climbalima/split-pcb-throughole/splanck throughhole.kicad_pcb

## KiCad design splanck throughhole.kicad_pcb (2016-11-23)

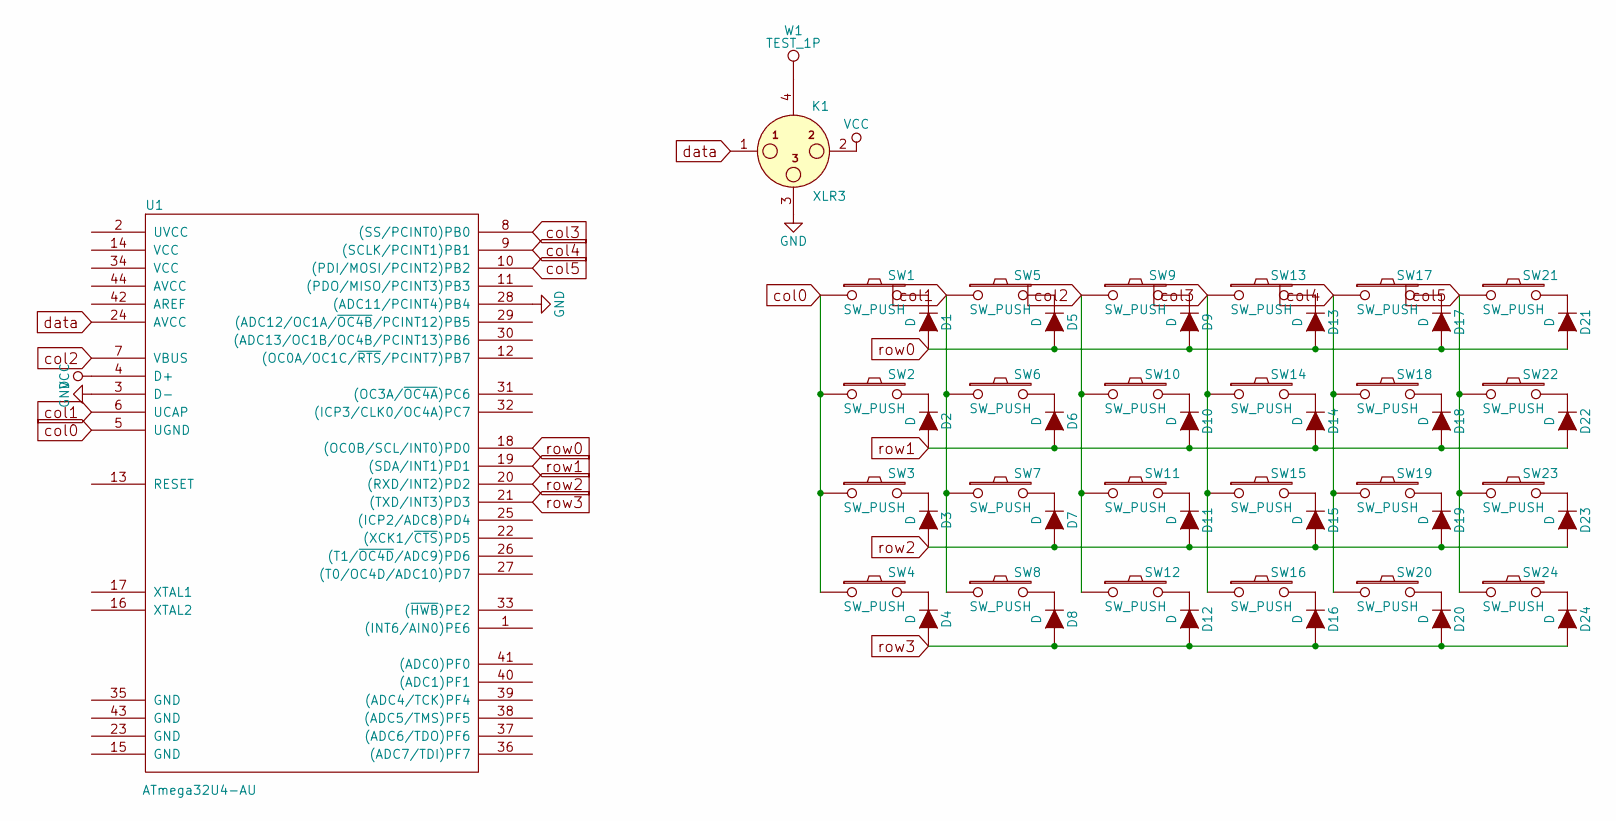
[picture p1: schematic splanck throughhole.sch]

Parts:
D1, D2, D3, D4, D5, D6, D7, D8, D9, D10, D11, D12, D13, D14, D15, D16, D17, D18, D19, D20, D21, D22, D23, D24: D; DIODE
K1: XLR3; 4pin35mmAudio
SW1, SW2, SW3, SW4, SW5, SW6, SW7, SW8, SW9, SW10, SW11, SW12, SW13, SW14, SW15, SW16, SW17, SW18, SW19, SW20, SW21, SW22, SW23, SW24: SW_PUSH; CHERRY_PCB_100H
U1: ATmega32U4-AU; TEENSY_2.0
W1: TEST_1P; SolderWirePad_single_0-8mmDrill

Connections:
GND: K1.3, U1.3 (D-), U1.28 ((ADC11/PCINT4)PB4)
unnamed: D1.1 (K), SW1.2
unnamed: D2.1 (K), SW2.2
unnamed: D3.1 (K), SW3.2
unnamed: D4.1 (K), SW4.2
unnamed: D5.1 (K), SW5.2
unnamed: D6.1 (K), SW6.2
unnamed: D7.1 (K), SW7.2
unnamed: D8.1 (K), SW8.2
unnamed: D9.1 (K), SW9.2
unnamed: D10.1 (K), SW10.2
unnamed: D11.1 (K), SW11.2
unnamed: D12.1 (K), SW12.2
unnamed: D13.1 (K), SW13.2
unnamed: D14.1 (K), SW14.2
unnamed: D15.1 (K), SW15.2
unnamed: D16.1 (K), SW16.2
unnamed: D17.1 (K), SW17.2
unnamed: D18.1 (K), SW18.2
unnamed: D19.1 (K), SW19.2
unnamed: D20.1 (K), SW20.2
unnamed: D21.1 (K), SW21.2
unnamed: D22.1 (K), SW22.2
unnamed: D23.1 (K), SW23.2
unnamed: D24.1 (K), SW24.2
unnamed 25: K1.4, W1.1; also elsewhere on the board
VCC: K1.2, U1.4 (D+)
col0: SW1.1, SW2.1, SW3.1, SW4.1, U1.5 (UGND)
col1: SW5.1, SW6.1, SW7.1, SW8.1, U1.6 (UCAP)
col2: SW9.1, SW10.1, SW11.1, SW12.1, U1.7 (VBUS)
col3: SW13.1, SW14.1, SW15.1, SW16.1, U1.8 ((SS/PCINT0)PB0)
col4: SW17.1, SW18.1, SW19.1, SW20.1, U1.9 ((SCLK/PCINT1)PB1)
col5: SW21.1, SW22.1, SW23.1, SW24.1, U1.10 ((PDI/MOSI/PCINT2)PB2)
data: K1.1, U1.24 (AVCC)
row0: D1.2 (A), D5.2 (A), D9.2 (A), D13.2 (A), D17.2 (A), D21.2 (A), U1.18 ((OC0B/SCL/INT0)PD0)
row1: D2.2 (A), D6.2 (A), D10.2 (A), D14.2 (A), D18.2 (A), D22.2 (A), U1.19 ((SDA/INT1)PD1)
row2: D3.2 (A), D7.2 (A), D11.2 (A), D15.2 (A), D19.2 (A), D23.2 (A), U1.20 ((RXD/INT2)PD2)
row3: D4.2 (A), D8.2 (A), D12.2 (A), D16.2 (A), D20.2 (A), D24.2 (A), U1.21 ((TXD/INT3)PD3)

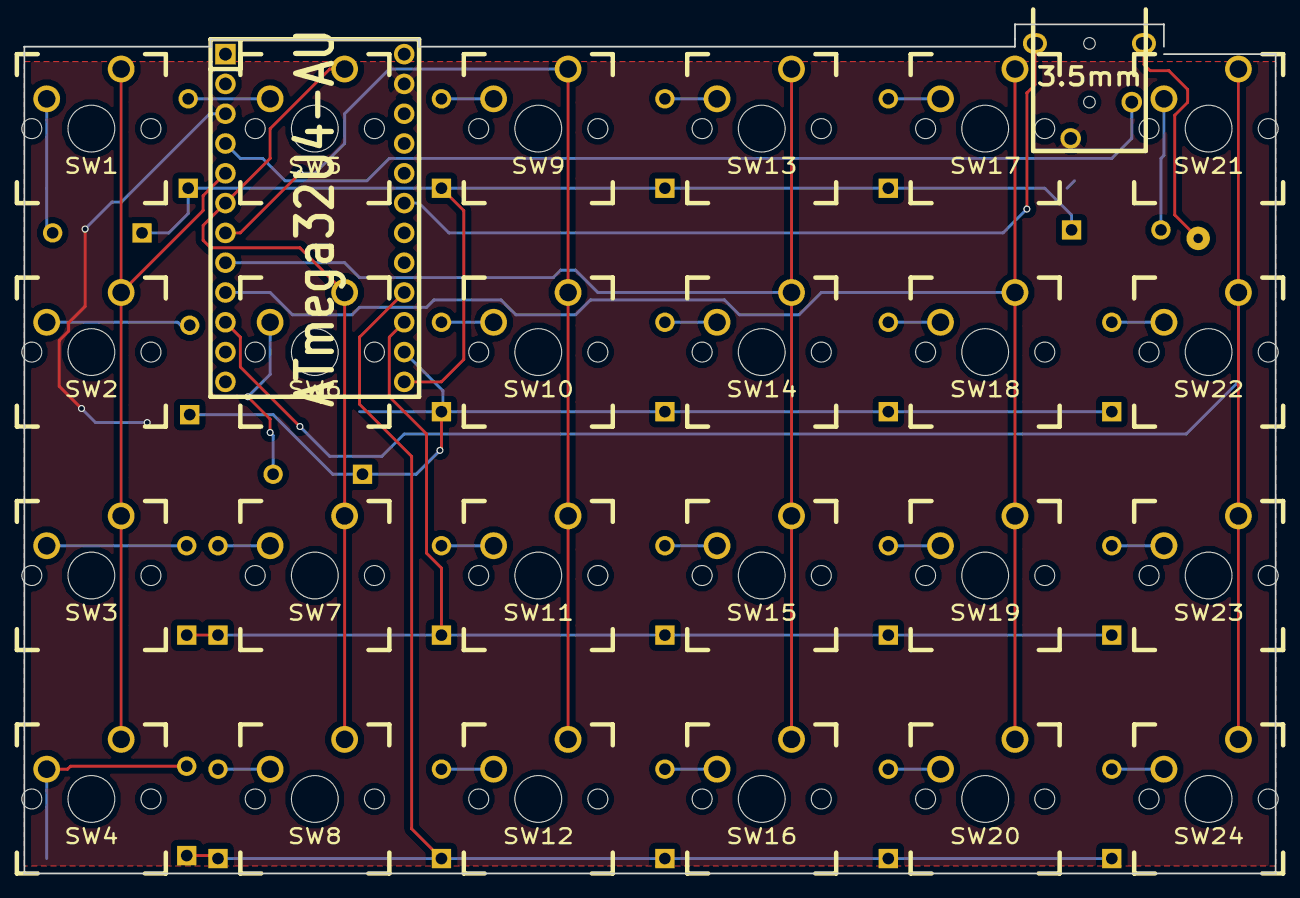
[picture p2: board splanck throughhole.kicad_pcb from above]

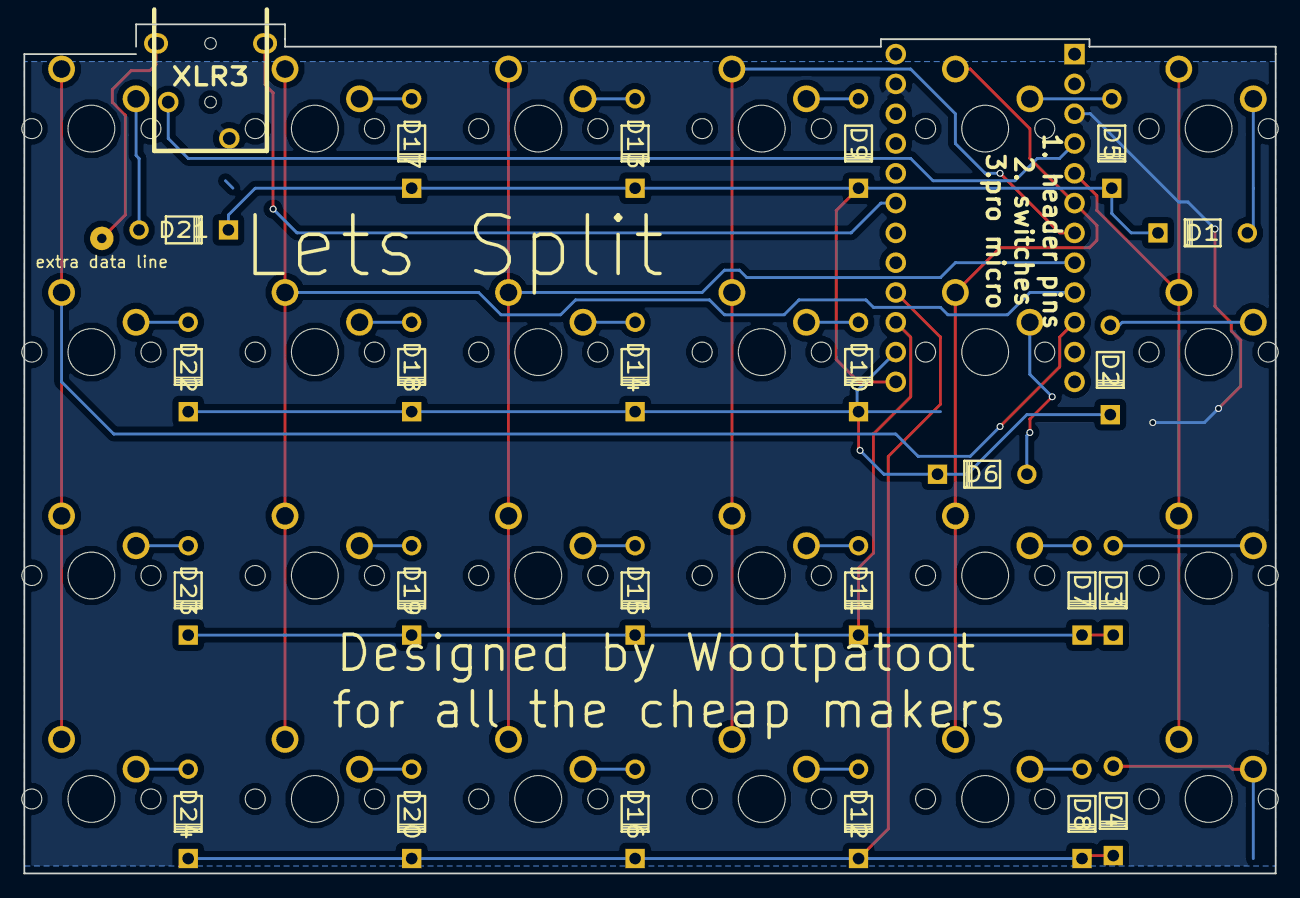
[picture p3: board splanck throughhole.kicad_pcb from below]

Board: 2 copper layers, 106.7 x 72.4 mm, 51 parts (25 on the bottom side), 38 nets.

Other parts of the board:
extra data line: TEST_1P; SolderWirePad_single_0-8mmDrill

Their connections:
unnamed 25: extra data line.1; also elsewhere on the board
