climbalima/split-pcb-throughole/(threads)

Thread 1 (2016-10-26):

Outdated Gerber File?

yinshanyang, 2016-10-26:
Hi there,

Made a run of PCBs using the gerber files, and found that there were some issues with the connections. Namely on pins 3 and 8.

For pin 3, it seems that for a serial connection to the slave controller, it should be connected to pin 3, the current gerber files connect the TRRS connector to pin 4.

For pin 8, it seems like it is not connected to any of the rows, though my inference is that it should be connected to the second row of keys.

I made these hardware hacks and my keyboard works.

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

climbalima, 2016-11-23:
They have been fixed as of now. Sorry I did not see this issue earlier

Closed 2016-12-18.
